bethanysciences/Communications_Console/_images/30w_voice_playback_module_hookup.jpeg

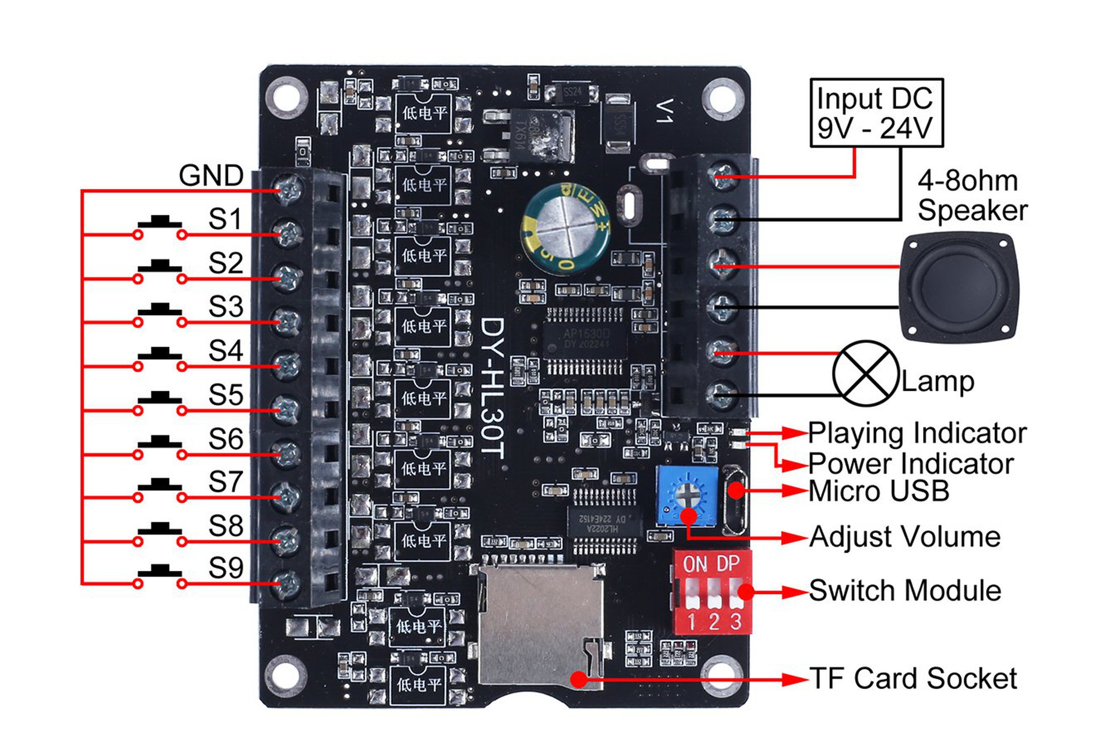
_images/30w_voice_playback_module_hookup.jpeg
