bethanysciences/Communications_Console/_images/30w_voice_playback_module_hookup_2.png

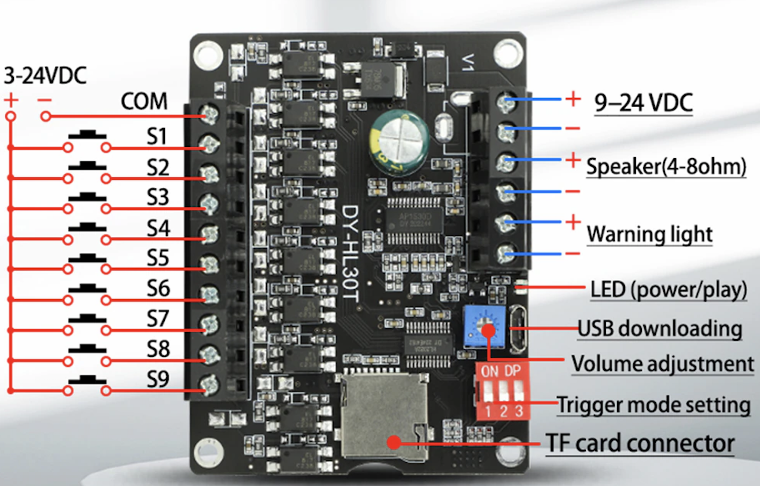
_images/30w_voice_playback_module_hookup_2.png
