bethanysciences/Communications_Console/_images/30w_voice_playback_module_top.png

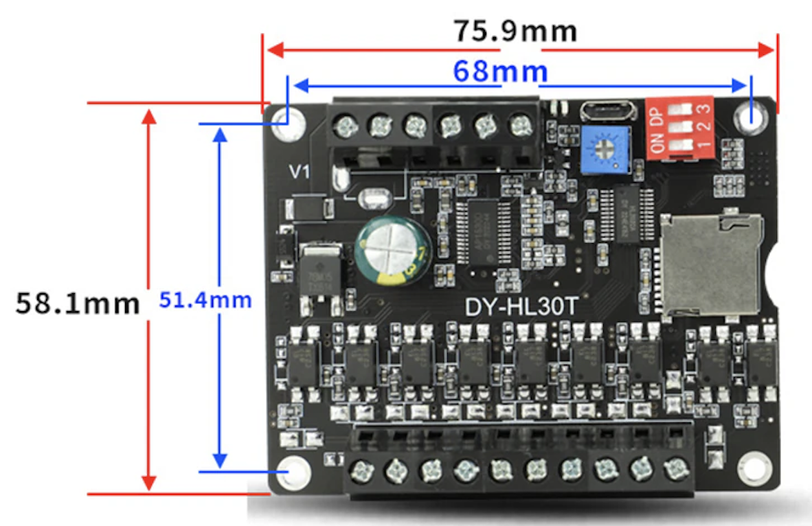
_images/30w_voice_playback_module_top.png
