bethanysciences/Communications_Console/_images/comms_center_install_wide.jpeg

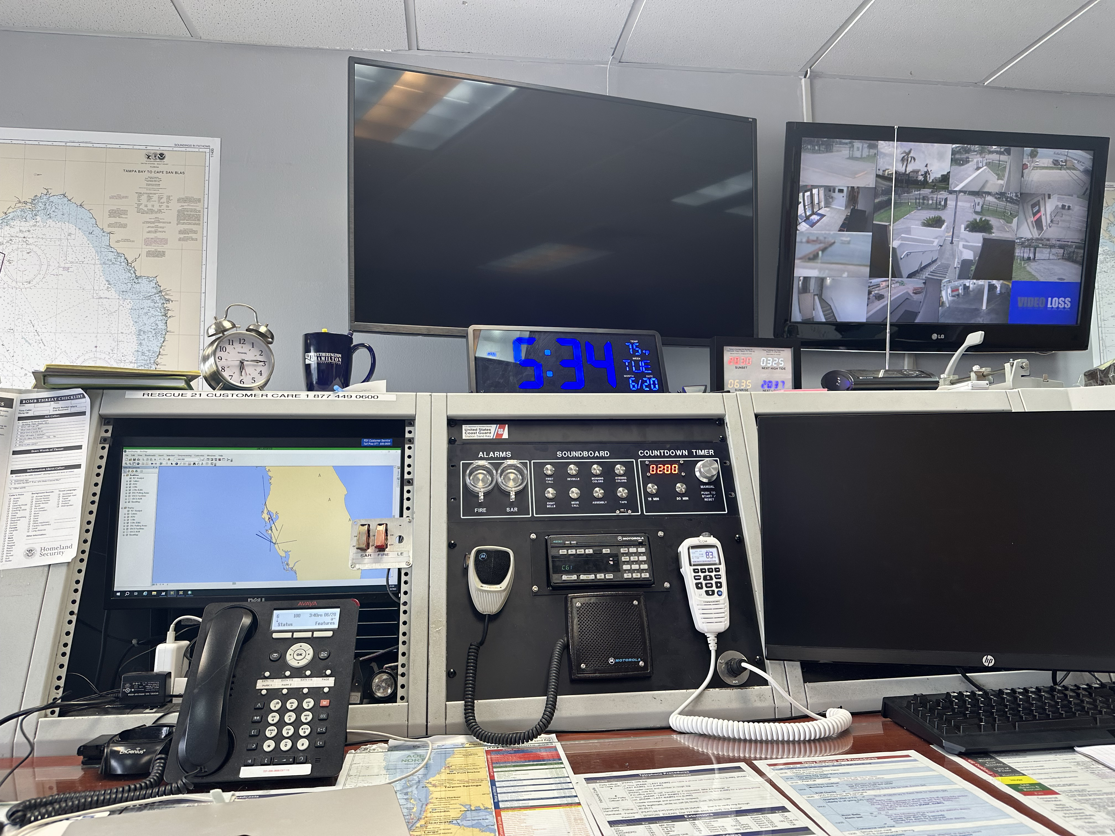
_images/comms_center_install_wide.jpeg
