bethanysciences/Communications_Console/_images/panel_wiring_alarm_sar.jpeg

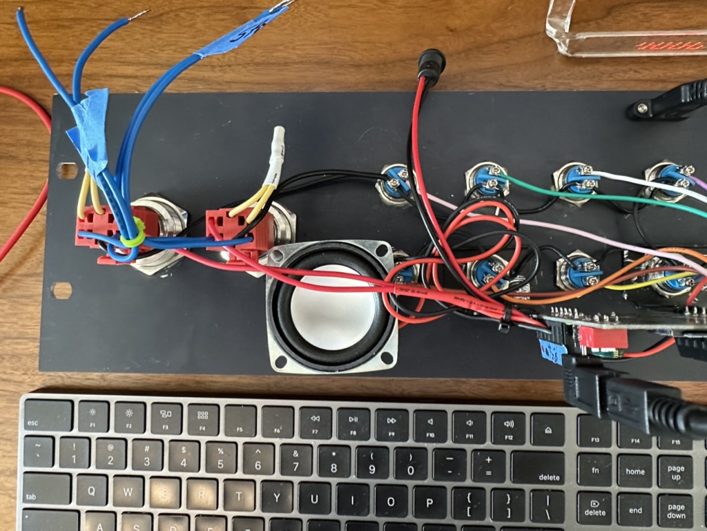
_images/panel_wiring_alarm_sar.jpeg
