bethanysciences/Communications_Console/_images/panel_wiring_countdown_side.jpeg

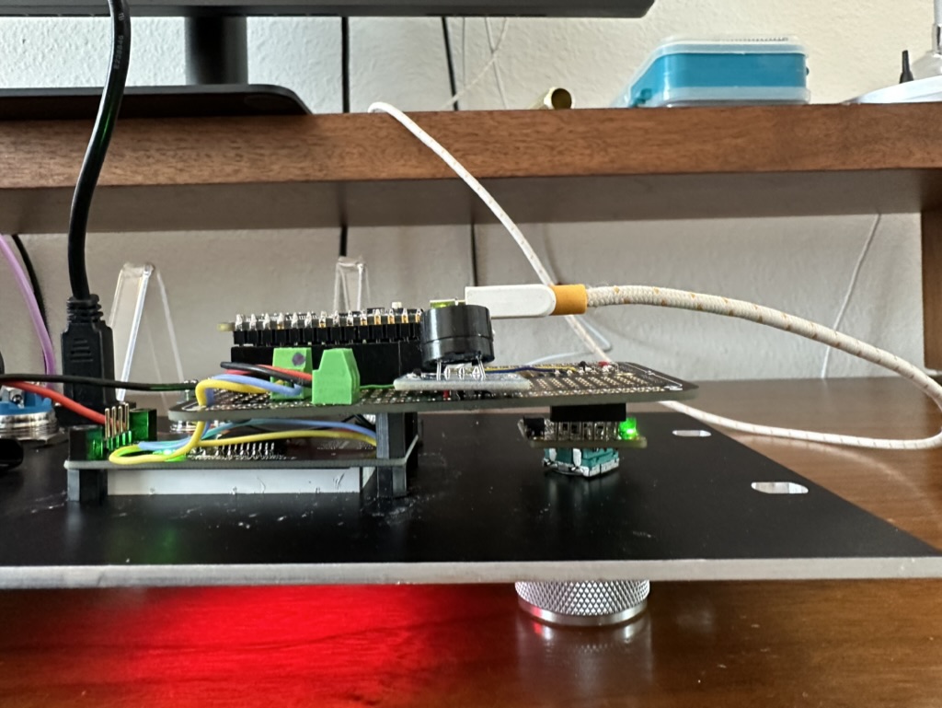
_images/panel_wiring_countdown_side.jpeg
