bethanysciences/Communications_Console/_images/panel_wiring_countdown_top.jpeg

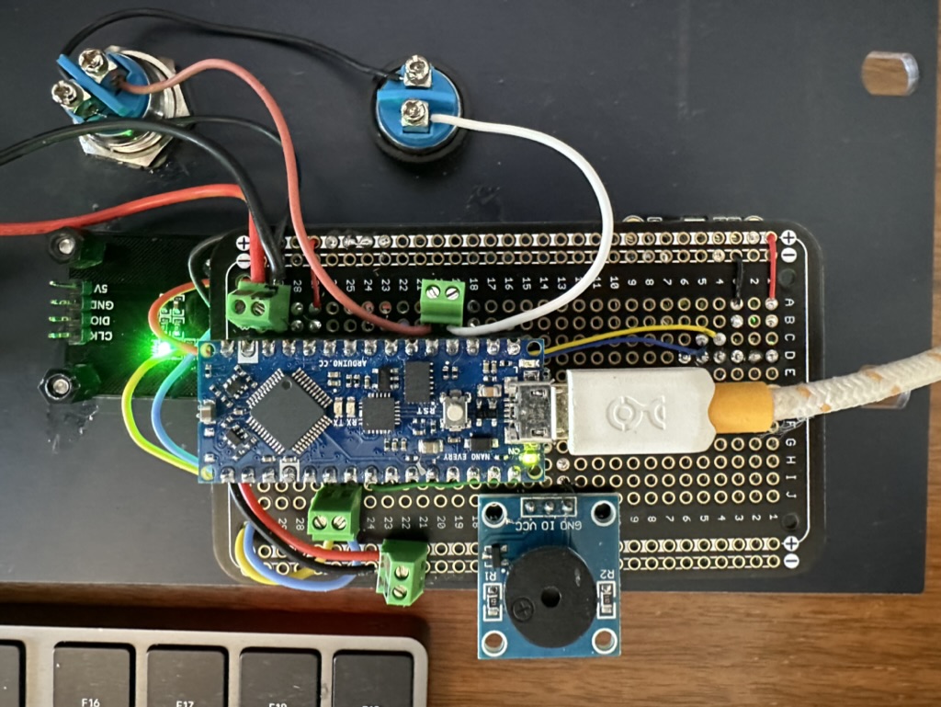
_images/panel_wiring_countdown_top.jpeg
