bethanysciences/Communications_Console/_images/panel_wiring_rear.jpeg

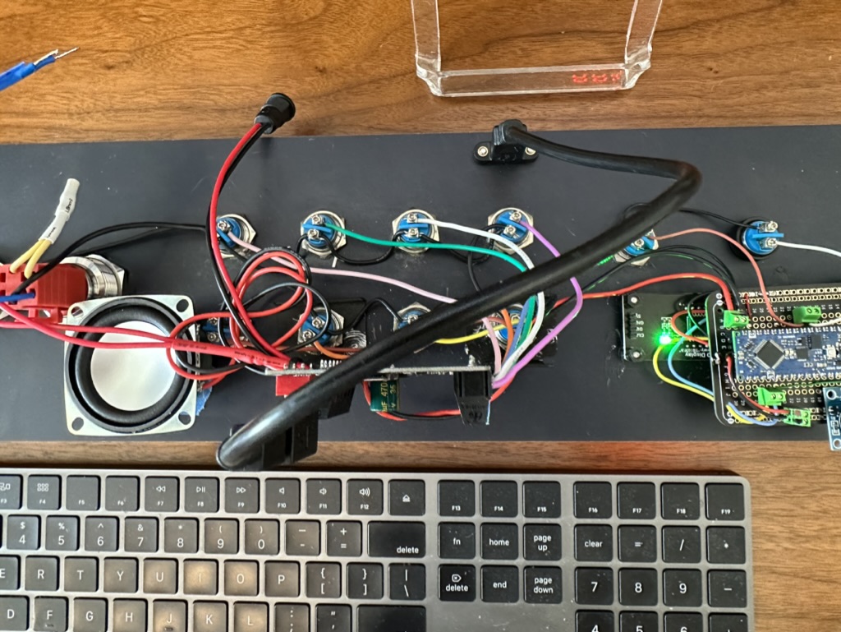
_images/panel_wiring_rear.jpeg
