bethanysciences/Communications_Console/_images/panel_wiring_soundboard_switches.jpeg

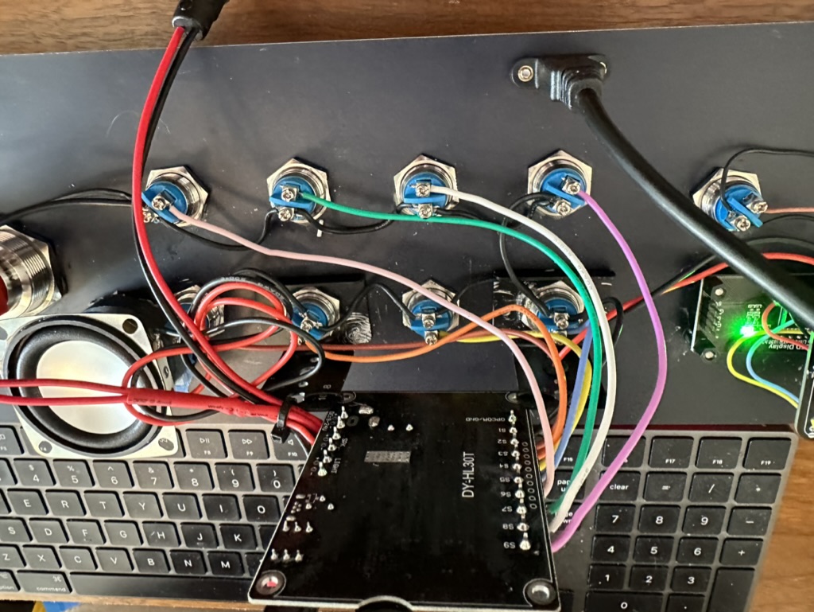
_images/panel_wiring_soundboard_switches.jpeg
