bethanysciences/Communications_Console/_images/panel_wiring_soundboard_top.jpeg

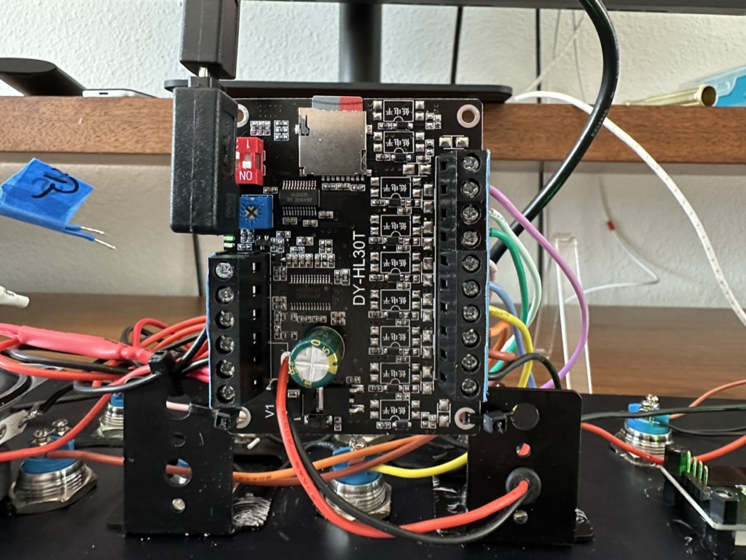
_images/panel_wiring_soundboard_top.jpeg
