bethanysciences/Communications_Console/_images/prototyping_test_board.jpeg

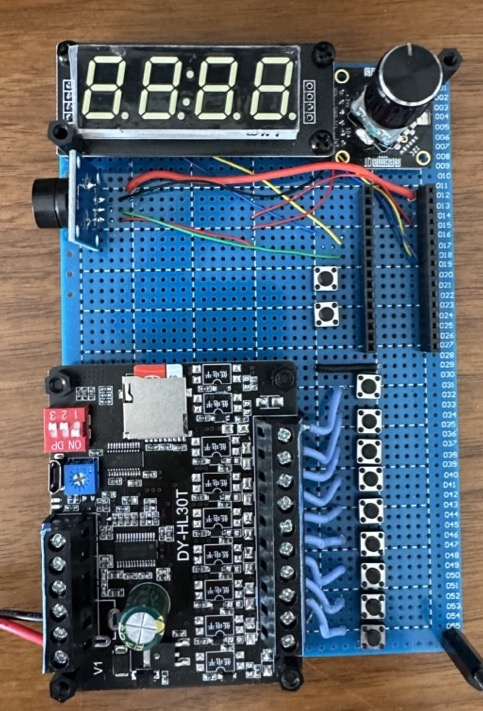
_images/prototyping_test_board.jpeg
