bethanysciences/Communications_Console/SSK Comms Console 03 20230621.pdf

# MAX1R

# Mono Auxiliary

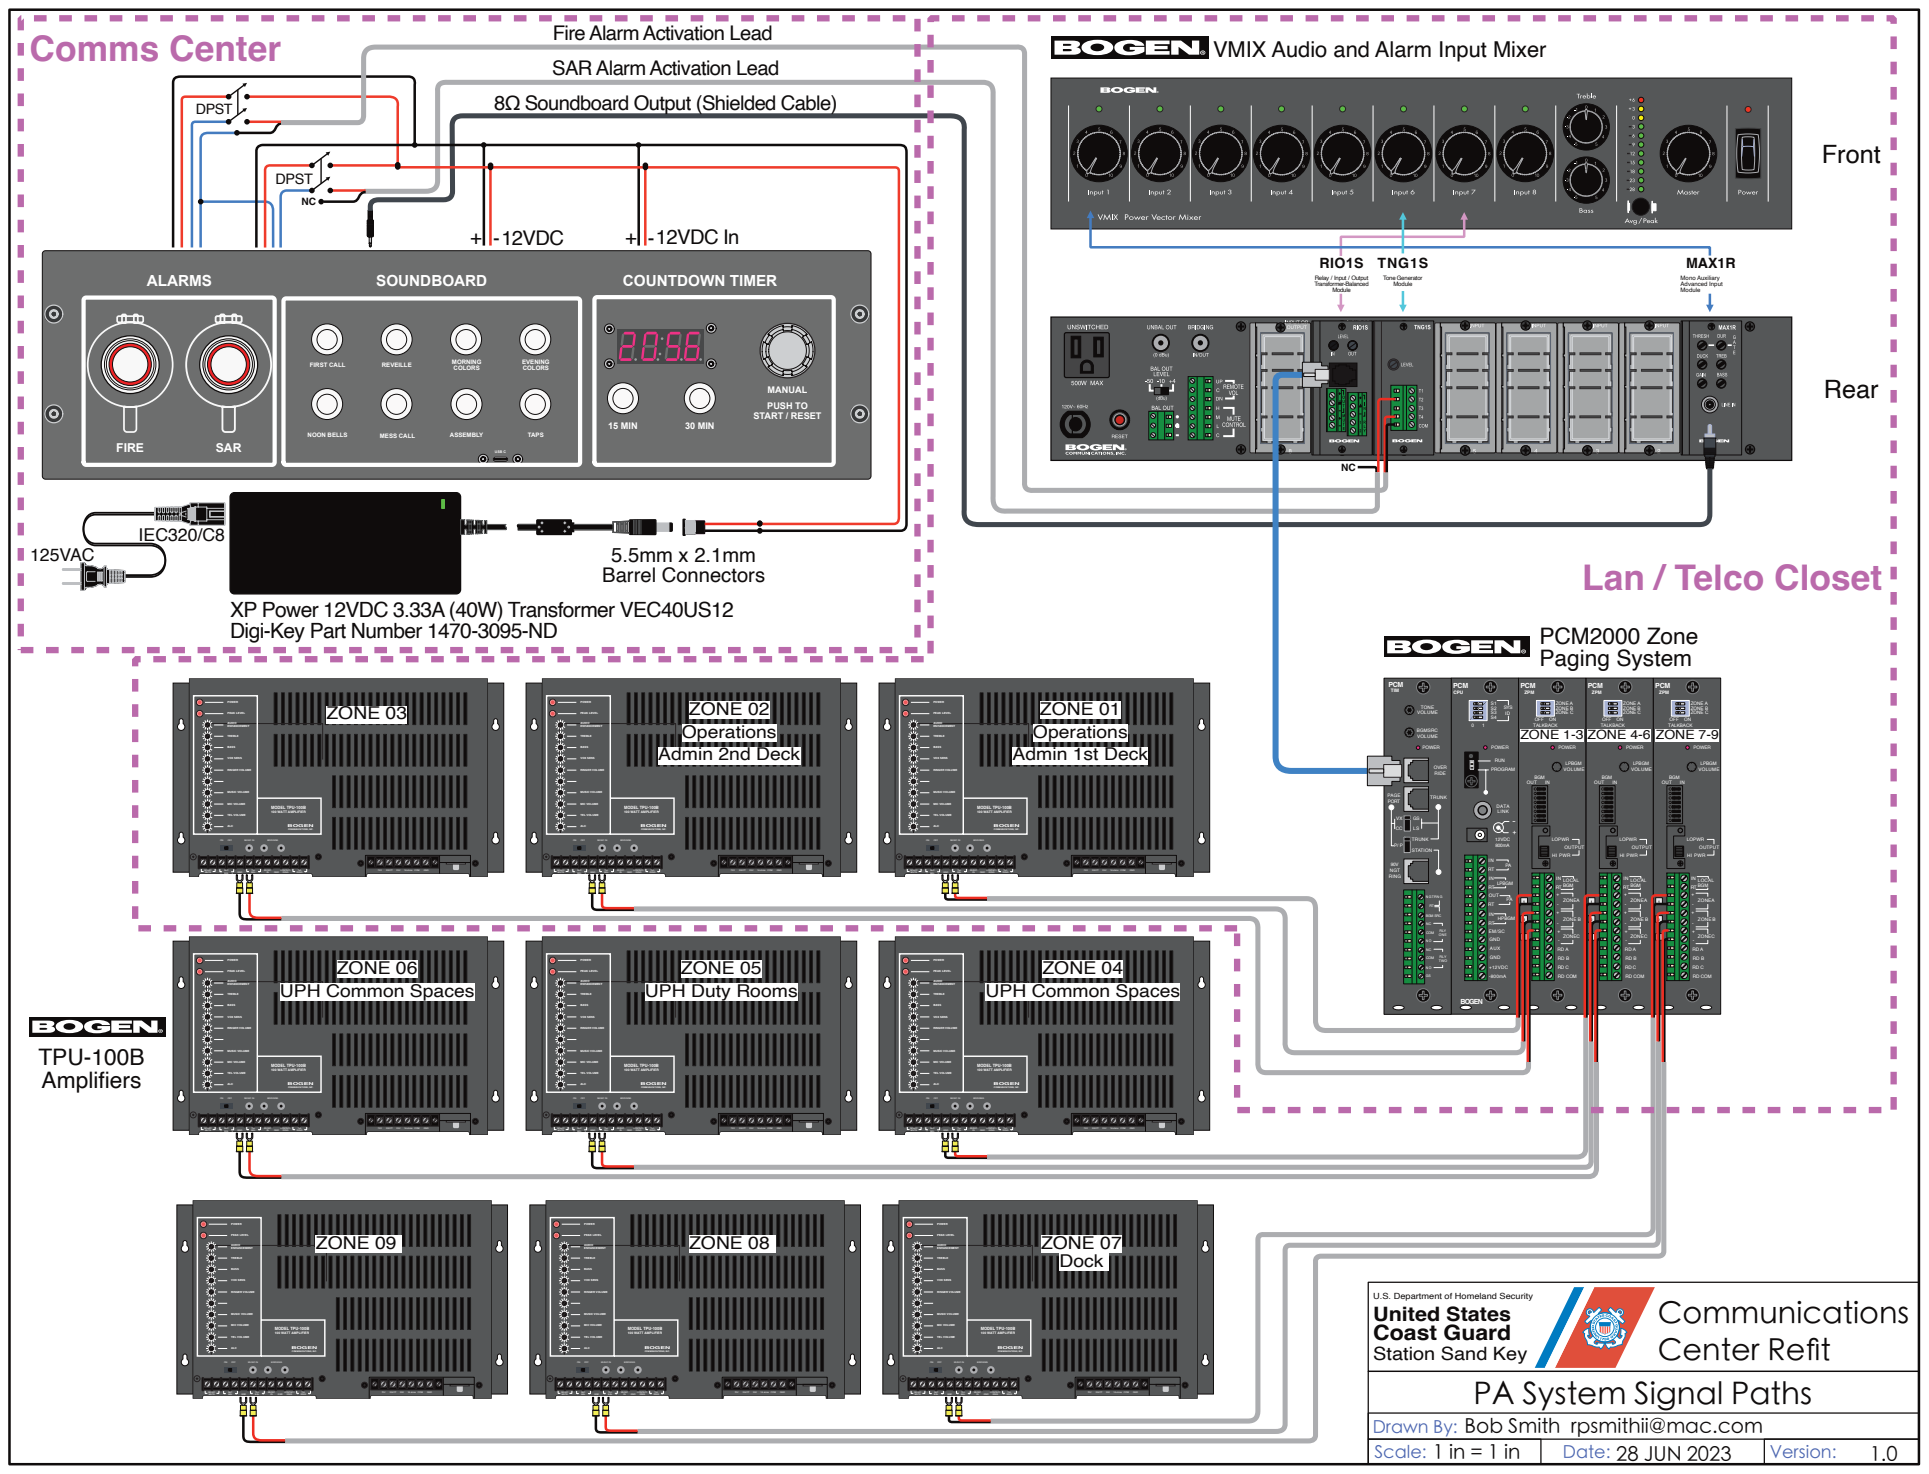
[picture p19: page 1]
Drawn By: Scale:; Date:; Version:; Communications Center Ret; 28 JUN 2023; BOGEN; 100 WATT AMPLIFIER; COMMUNICATIONS, INC.; MODEL TPU-100B; ALC; TEL VOLUME; MIC VOLUME; MUSIC VOLUME; RINGER VOLUME; VOX SENS; BASS; TREBLE; AUDIO ENHANCEMENT; PEAK LEVEL; POWER; MUSIC; MUTE; MIC -; BAL; GND; GND TEL; MUSIC IN; CONTACT RING; OFF; BRIDGING; TEL T; RING; 25VCT; 16 ohms COM; PCM; ZPM; RD COM; ZONE A ZONE B ZONE C; OFF ON TALKBACK; ZONEA; LOCAL BGM; ZONE B; ZONEC; LPBGM VOLUME; LOPWR; HI PWR; OUTPUT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

Fire Alarm Activation Lead
SAR Alarm Activation Lead

VMIX Audio and Alarm Input Mixer

8Ω Soundboard Output (Shielded Cable)

Relay / Input / Output
Transformer-Balanced

Lan / Telco Closet

XP Power 12VDC 3.33A (40W) Transformer VEC40US12
Digi-Key Part Number 1470-3095-ND

ZONE 05
UPH Duty Rooms

U.S. Department of Homeland Security
United States
Coast Guard
Station Sand Key

PA System Signal Paths
Bob Smith rpsmithii@mac.com

# SOUNDBOARD

# COUNTDOWN TIMER

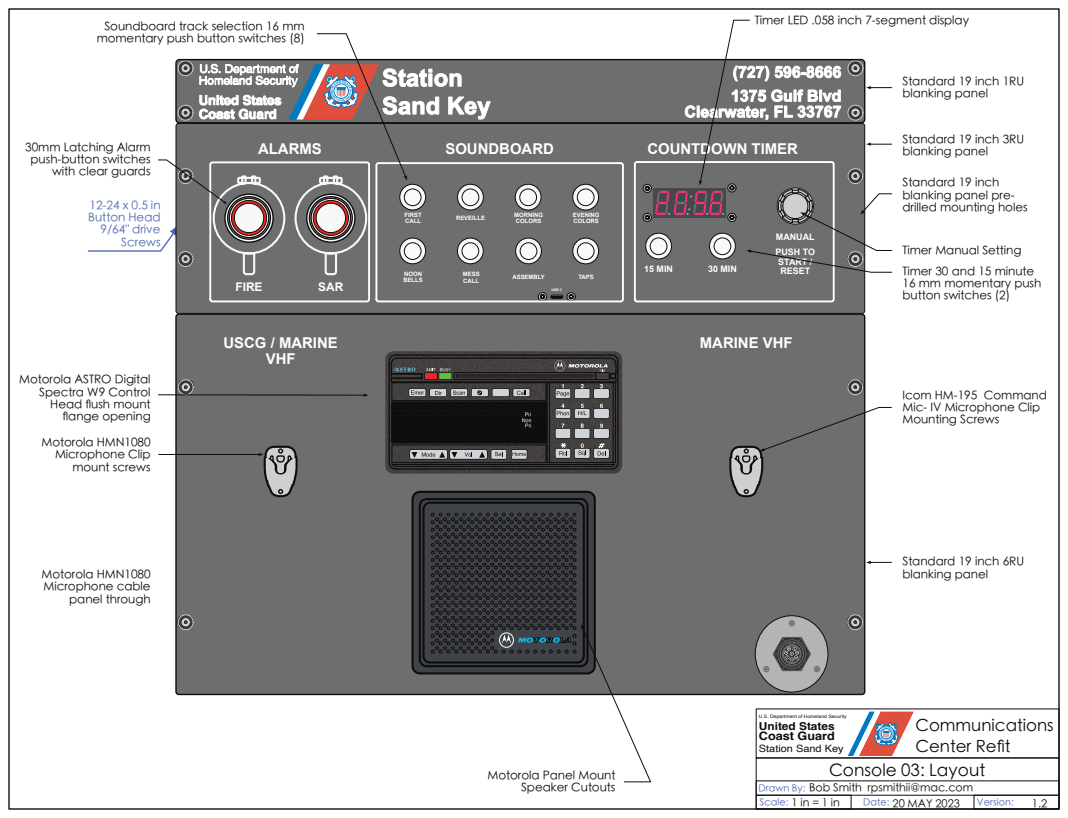
[picture p20: page 2]
Drawn By: Scale:; Date:; Version:; Communications Center Ret; 20 MAY 2023; 12-24 x 0.5 in Button Head 9/64" drive Screws; USCG / MARINE VHF; MARINE VHF; MESS; ASSEMBLY; TAPS CALL; NOON BELLS; EVENING COLORS; MORNING; USB C; MANUAL; PUSH TO START /; 15 MIN; 30 MIN; RESET; FIRE; SAR; ALARMS; 1375 Gulf Blvd Clearwater, FL 33767; (727) 596-8666 Station Sand Key; Standard 19 inch 6RU blanking panel; Standard 19 inch 3RU blanking panel; Standard 19 inch 1RU blanking panel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

Soundboard track selection 16 mm
momentary push button switches (8)

Timer LED .058 inch 7-segment display

30mm Latching Alarm
push-button switches
with clear guards

Standard 19 inch
blanking panel pre-
drilled mounting holes

COLORS REVEILLE FIRST
CALL

Timer Manual Setting
Timer 30 and 15 minute
16 mm momentary push
button switches (2)

Motorola ASTRO Digital
Spectra W9 Control
Head ush mount
ange opening

Icom HM-195 Command
Mic- IV Microphone Clip
Mounting Screws

U.S. Department of Homeland Security
United States
Coast Guard
Station Sand Key

Console 03: Layout
Bob Smith rpsmithii@mac.com

Motorola Panel Mount
Speaker Cutouts
