bethanysciences/Communications_Console/SSK_Comms_Console_03_PA_Signal_Path_20230628.pdf

# MAX1R

# Mono Auxiliary

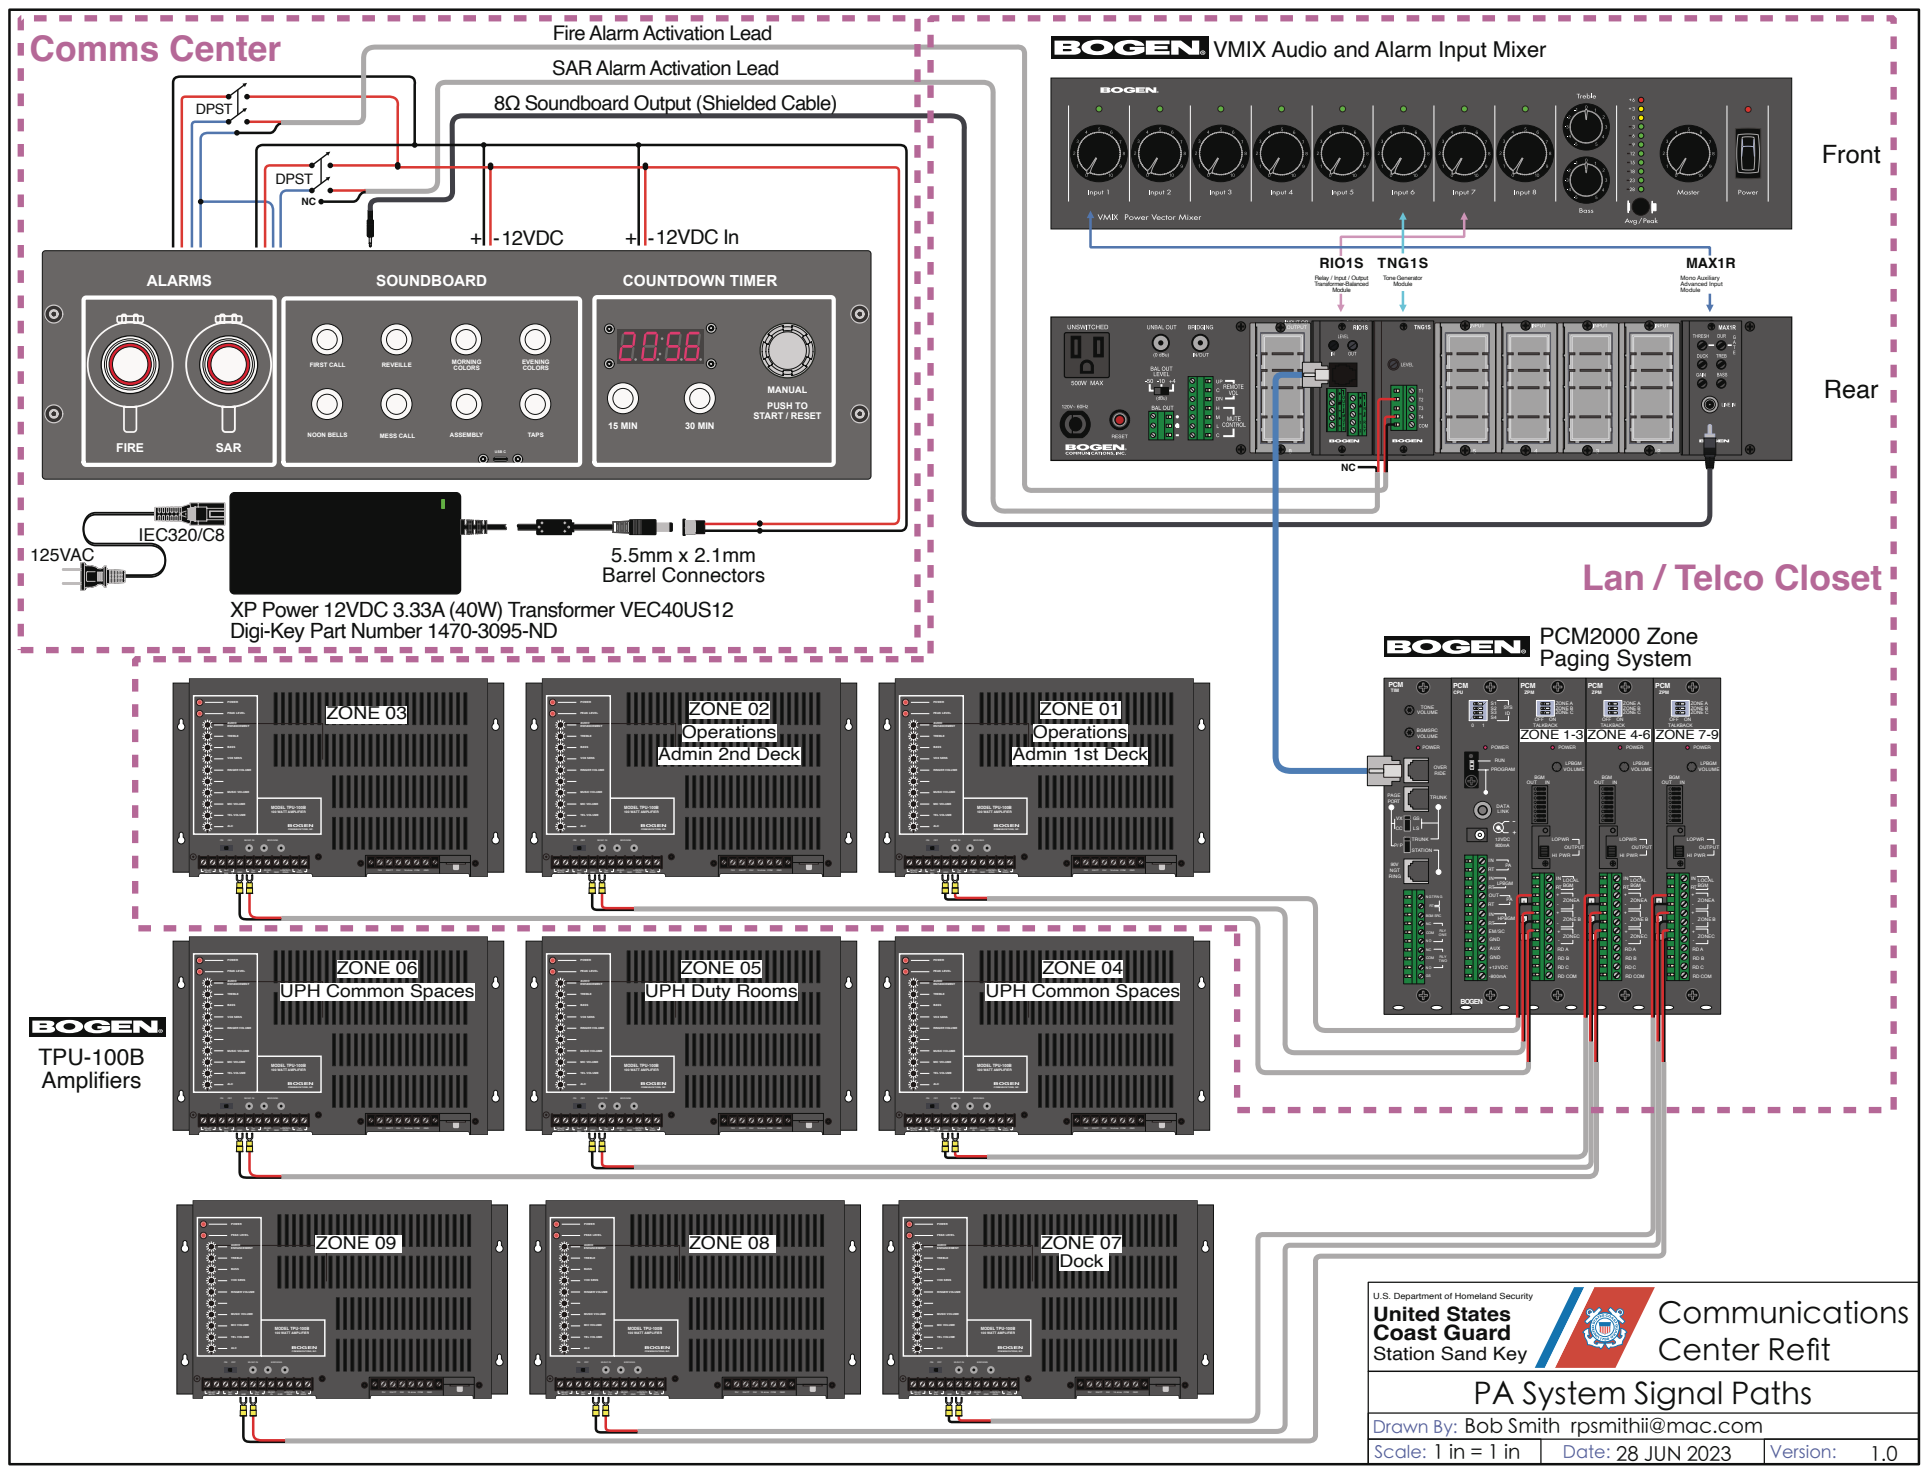
[picture p21: page 1]
Drawn By: Scale:; Date:; Version:; Communications Center Ret; 28 JUN 2023; BOGEN; 100 WATT AMPLIFIER; COMMUNICATIONS, INC.; MODEL TPU-100B; ALC; TEL VOLUME; MIC VOLUME; MUSIC VOLUME; RINGER VOLUME; VOX SENS; BASS; TREBLE; AUDIO ENHANCEMENT; PEAK LEVEL; POWER; MUSIC; MUTE; MIC -; BAL; GND; GND TEL; MUSIC IN; CONTACT RING; OFF; BRIDGING; TEL; RING; 25VCT; 16 ohms COM; PCM; ZPM; RD COM; ZONE A ZONE B ZONE C OFF ON TALKBACK; ZONEA; LOCAL BGM; ZONE B; + - ZONEC; LPBGM VOLUME; LOPWR; HI PWR; OUTPUT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

Fire Alarm Activation Lead
SAR Alarm Activation Lead
8Ω Soundboard Output (Shielded Cable)

VMIX Audio and Alarm Input Mixer

RIO1S Relay / Input / Output

Transformer-Balanced Module

Lan / Telco Closet

XP Power 12VDC 3.33A (40W) Transformer VEC40US12
Digi-Key Part Number 1470-3095-ND

ZONE A
ZONE B
ZONE C
ZONE 1-3 ZONE 4-6 ZONE 7-9

ZONE 05
UPH Duty Rooms

U.S. Department of Homeland Security
United States
Coast Guard
Station Sand Key

PA System Signal Paths
Bob Smith rpsmithii@mac.com
