bethanysciences/Communications_Console/SSK_Comms_Console_03_PA_Signal_Path_Block_20230628.pdf

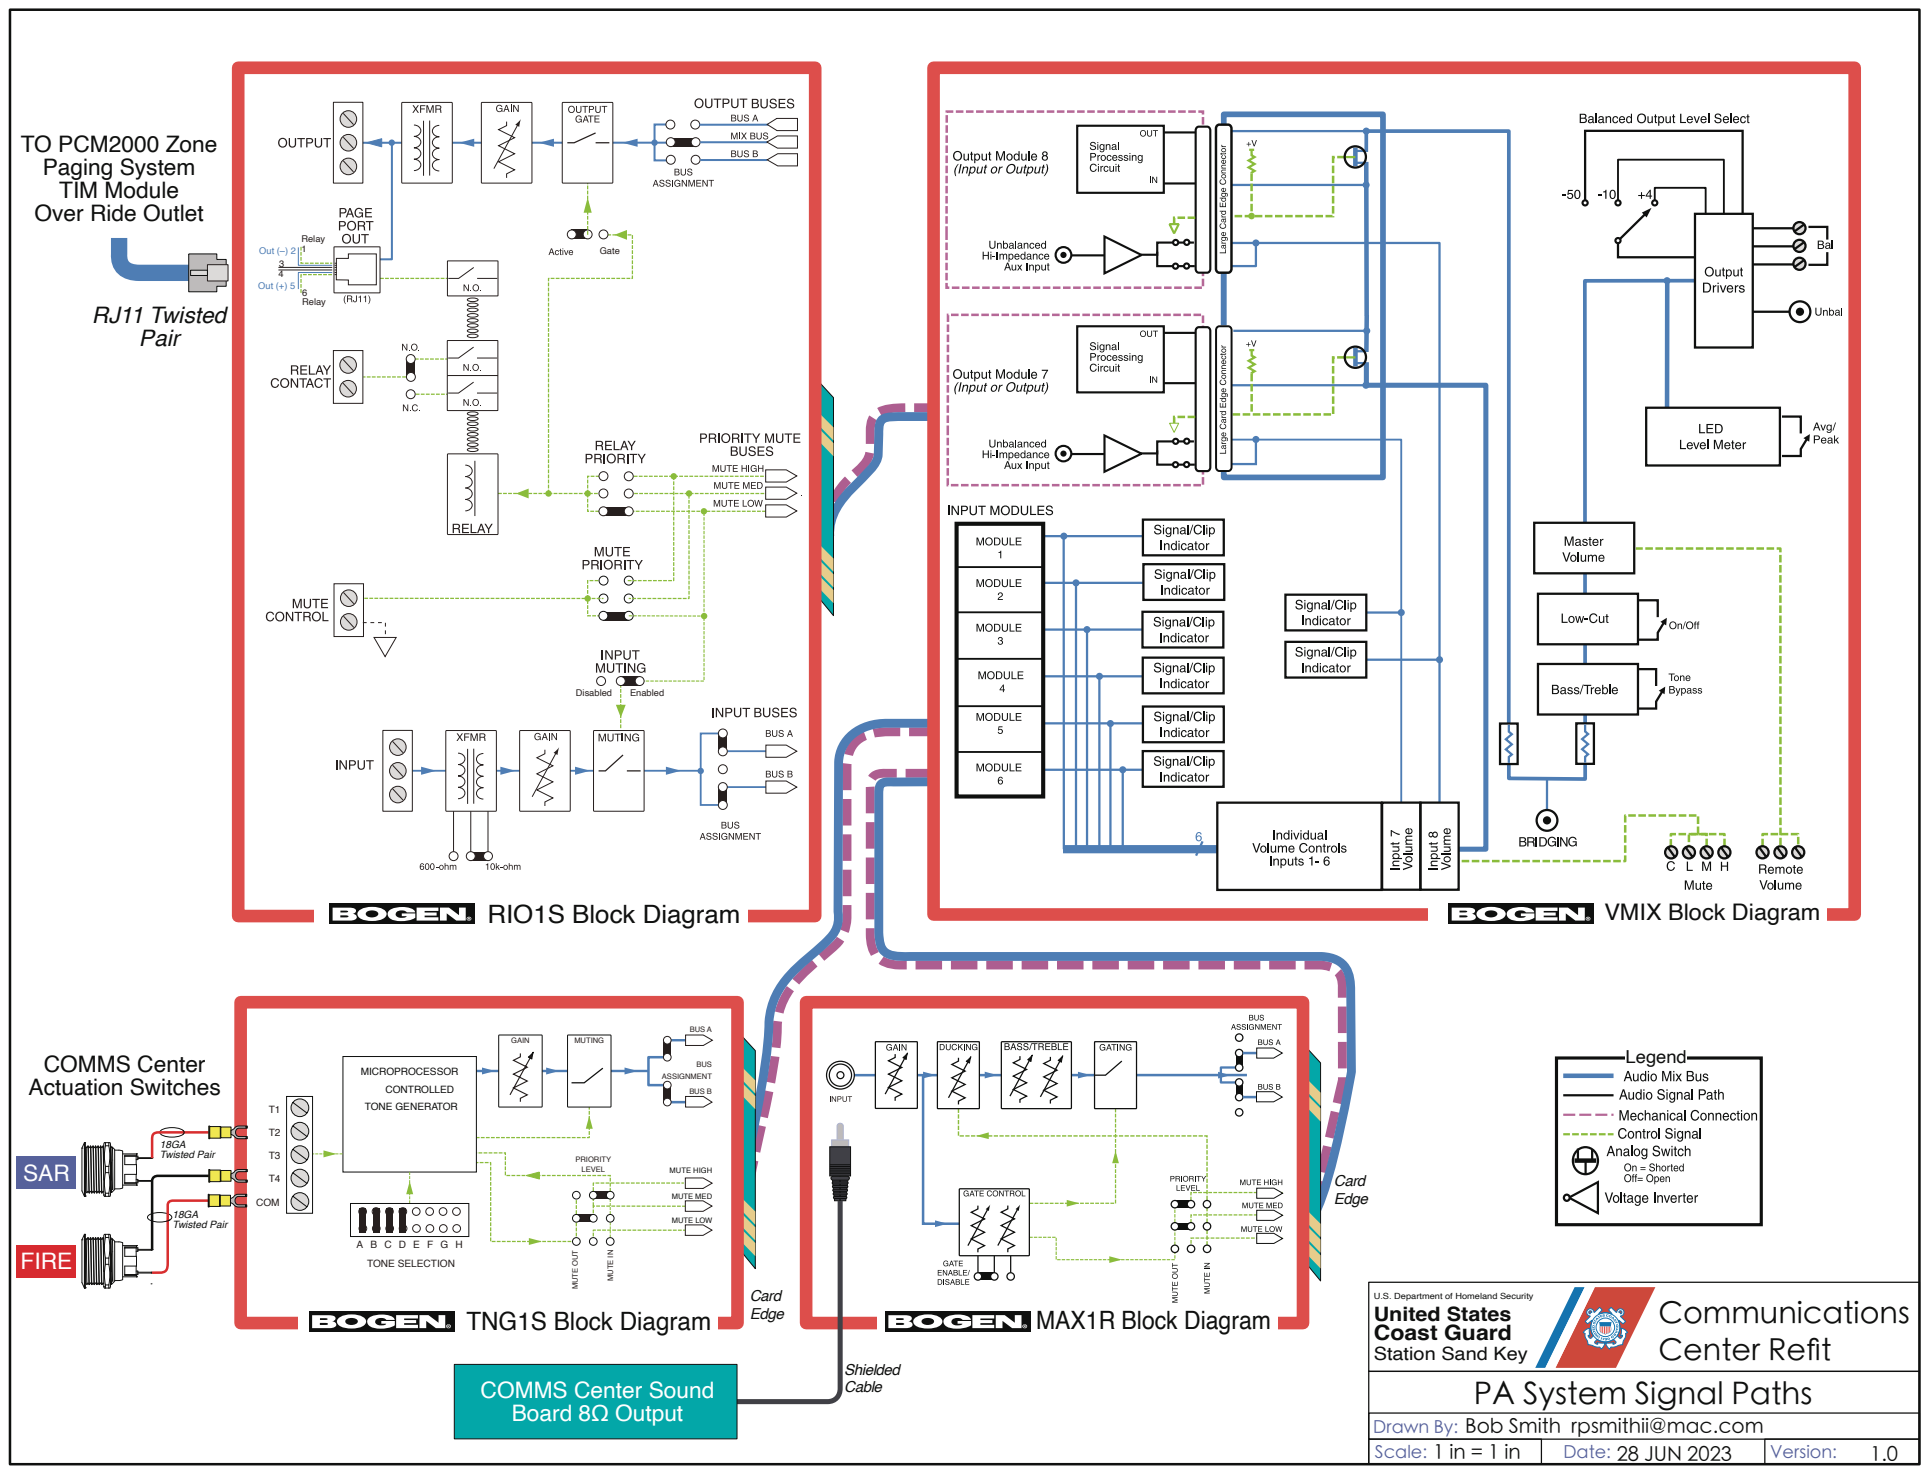
[picture p22: page 1]
Drawn By: Scale:; Date:; Version:; Communications Center Ret; 28 JUN 2023; Legend; MUTE IN; MUTE OUT; BUS; ASSIGNMENT; PRIORITY LEVEL; BUS A; BUS B; MUTE LOW; MUTE MED; MUTE HIGH; MICROPROCESSOR; CONTROLLED; TONE GENERATOR; COM; GAIN; MUTING; TONE SELECTION; TNG1S Block Diagram; MAX1R Block Diagram; Disabled; Enabled; Relay 1; 6 Relay; Out (–) 2 3 4 Out (+) 5; Gate; RIO1S Block Diagram; VMIX Block Diagram; COMMS Center Actuation Switches; 18GA Twisted Pair; RJ11 Twisted Pair; FIRE; SAR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

TO PCM2000 Zone
Paging System
TIM Module
Over Ride Outlet

U.S. Department of Homeland Security
United States
Coast Guard
Station Sand Key

COMMS Center Sound
Board 8Ω Output

PA System Signal Paths
Bob Smith rpsmithii@mac.com
